kevinlin1996/MechBot/README.md

# MechBot
This project modifies the Ryerson MIE MechBot by implementing the LiDAR V3 and the SF-30
