kevinlin1996/MechBot/Capstone_bb.png

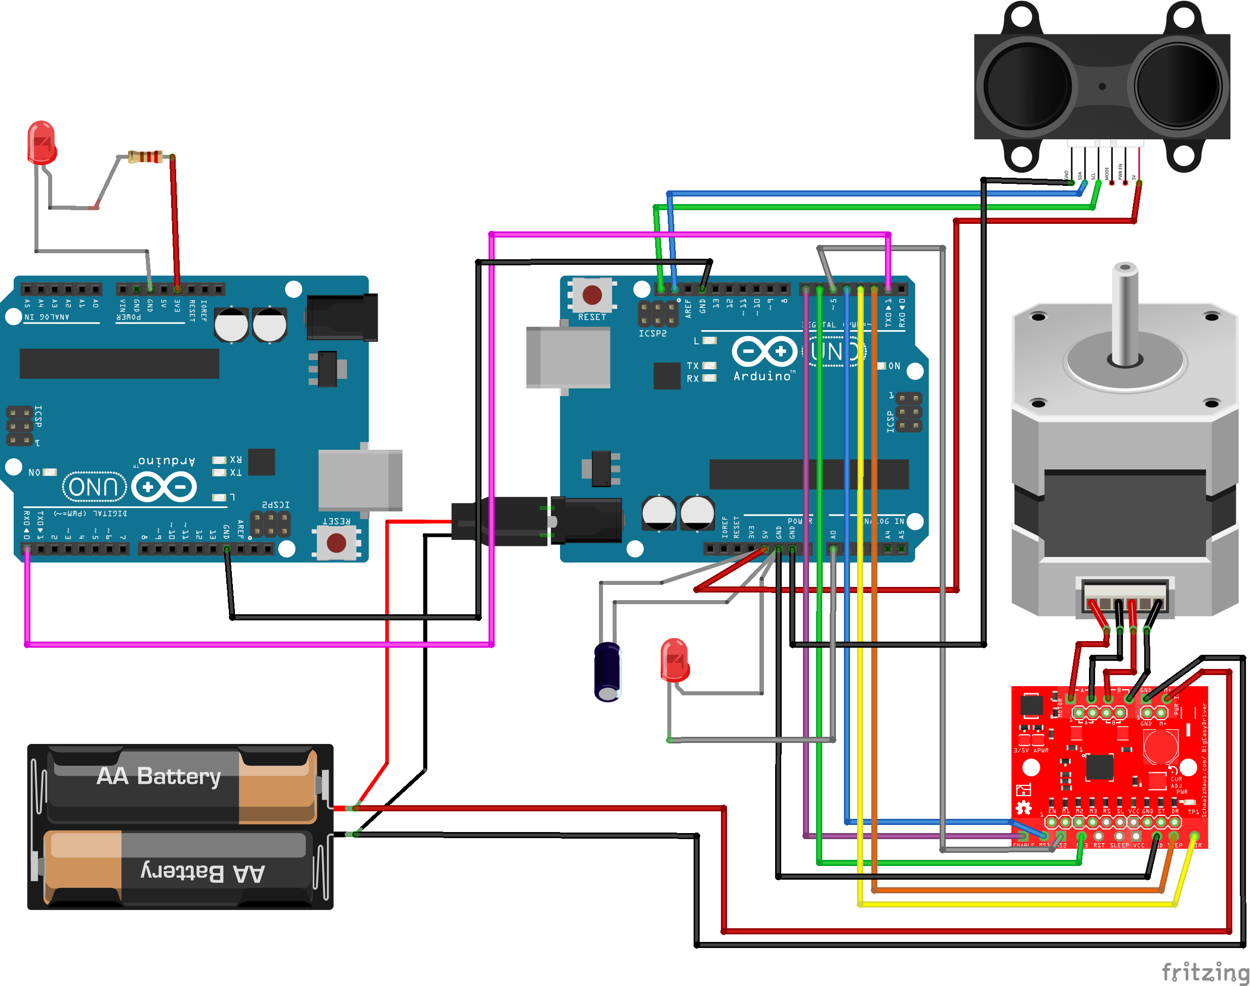
Capstone_bb.png
