kevinlin1996/MechBot/LED_Test.ino

int analogPin = 0;
int val = 0;

void setup() {
  // put your setup code here, to run once:

  Serial.begin(9600);          //  setup serial


}

void loop() {
  val = analogRead(analogPin);    // read the input pin

  Serial.println(val);             // debug value
}
